samer-cyber/Robotic-Arm/docs/README.md

# Docs

| | |
|---|---|
| [calibration.md](calibration.md) | gear ratios, signs and zero, gripper, tool point: do this after flashing 1.3.0 |
| [roadmap.md](roadmap.md) | what to build next, in small steps, and which hardware upgrades are worth it |
| [gearbox.md](gearbox.md) | how the inverted cycloids work, and the J2 disc B interference |
| [wiring.md](wiring.md) | as-built pin map, power, and the schematic |
| [datasheets.md](datasheets.md) | where to get the vendor PDFs |
| [notes/direction-over-uart.md](notes/direction-over-uart.md) | firmware 1.2.0: steering the steppers over UART after the DIR pins died |
