samer-cyber/Robotic-Arm/docs/datasheets.md

# Datasheets

Vendor PDFs are not redistributed here. Keep local copies in
`hardware/datasheets/` (gitignored).

| Part | Where |
|---|---|
| TMC2209 stepper driver | [Analog Devices / Trinamic](https://www.analog.com/en/products/tmc2209.html) |
| 17HS4401S NEMA 17 stepper | the seller's sheet: 1.5 A/phase, 40 mm body, 5 mm D-shaft |
| MG996R / MG995 servos | TowerPro |
| ESP32-WROOM-32 | [Espressif](https://www.espressif.com/en/support/documents/technical-documents) |
| OAK-D SR camera | [Luxonis docs](https://docs.luxonis.com/hardware/products/OAK-D%20SR) |
| Joint-node PCB parts (ESP32-C3, MT6701, SIT65HVD230, AP63203, MP1584, USBLC6) | LCSC part pages, imported with `hardware/electronics/tools/import_lcsc.ps1` |
| CAN bus stepper reference design | "Things by Josh", the joint-node PCB's inspiration |
