samer-cyber/Robotic-Arm/hardware/calculators/Cycloidal gearbox calculator - pins.xlsx

- | CYCLOIDAL GEARBOX DESIGN - PINS VARIANT
 | ORANGE = you decide | PEACH = measure on your printer | GREY = hardware fact | LIGHT GREY = fixed constant, leave alone | BLUE = calculated | GREEN = check. Fill top to bottom, then copy the yellow block at the bottom into cycloidal_generator_pins.py.
1. YOUR MOTOR AND ITS SHAFT
T_m | Motor holding torque | 0.4 | N.m | 17HS4401S = 0.40 nameplate.
D_sh | Motor shaft diameter | 5 | mm | NEMA 17 = 5.0.
D_boss | Motor front boss diameter | 22 | mm | The raised pilot on the motor face.
L_boss | Boss length | 2 | mm | First section of the shaft, at the motor face.
L_round | Smooth round section length | 3 | mm | Between the boss and the D-cut.
L_dcut | D-cut section length | 18 | mm | The part the eccentric keys onto.
t_stand | Arm-body wall (motor to gearbox) | 3.5 | mm | The plate the motor bolts to. It EATS shaft: everything below is measured from the gearbox back face, not the motor face.
FTO | D-shaft flat-to-opposite-side | 4.5 | mm | Measured. Flat is 0.5 deep on a 5 mm shaft.
2. RATIO HELPER (optional)
T_want | Output torque you need | 7 | N.m | From the arm sizing calculator.
eta | Efficiency | 0.65 | - | Printed rollers dry 0.40-0.55 | greased 0.55-0.70 | steel dowels greased 0.70-0.85.
i_sug | -> suggested ratio |  | - | T_want / (motor x efficiency).
L_lev | MEASURED lever length | 200 | mm | Test/torque_test.py implements this.
m_scale | MEASURED scale reading at breakaway | 3565 | g | Zero the scale with the lever on it.
eta_m | -> your MEASURED efficiency |  | - | Put this back into the efficiency cell.
3. THE DECISIONS
i | Reduction ratio | 15 | - | Eccentricity is E = lambda x R / (i+1), so ratio and gearbox size TRADE OFF. Check the E verdict near the bottom before committing.
D_big | LARGE (output) bearing OUTER diameter | 52 | mm | Your size knob. R = D_big/2. A 6808 is 52.
W_big | large bearing width | 7 | mm
d_ci | CAM bearing inner diameter | 8 | mm | 608 = 8. -> eccentric journal.
d_co | cam bearing outer diameter | 22 | mm | 608 = 22. -> disc bore.
w_c | cam bearing width | 7 | mm | 608 = 7. -> disc thickness AND cavity length.
N_o | Number of output pins | 6 | - | MUST BE EVEN (4, 6 or 8).
D_o | Output PIN diameter | 4 | mm | Whatever pin you have.
5. PROFILE CLEARANCE (printer-dependent, NOT live in Fusion)
c | Profile clearance | 0.06 | mm | Shrinks the disc lobe profile for a running fit. PLA 0.05-0.08 | PETG 0.10-0.15 | ABS 0.15-0.20. Feeds every point of the spline, so changing it means re-running the script.
6. TOLERANCES - these five are LIVE Fusion parameters, all independent
t_bore | tol_disc_bore - disc centre bore | 0.1 | mm | Cam bearing OUTER race into the printed disc. Bore = d_co + this.
t_journal | tol_journal - eccentric journals | 0.1 | mm | Cam bearing INNER race onto the eccentric. Journal = d_ci - this. Separate from the bore because a thin disc shrinks onto a bearing while a shaft does not.
t_seat | tol_big_seat - big bearing seat | 0.1 | mm | Big output bearing into the stiff outer ring. Usually wants LESS than the inner fits.
t_mbore | tol_motor_bore - motor D-shaft bore | 0.05 | mm | Motor shaft into the eccentric.
t_ohole | tol_out_hole - output hole print allowance | 0.1 | mm | ON TOP of the geometric pin + 2E. Zero here guarantees binding if the printer runs undersize - that was the cause of the wobble and the Z-jumping. Set it properly: print one disc, caliper a hole, use (nominal - measured) + 0.05.
7. HOUSING AND AXIAL STACK
W | Wall thickness (outer wall + seat ring) | 3 | mm
BW | Back wall thickness | 5 | mm | THE ONE YOU TUNE. Must clear the M3 counterbore - see check 7.
cb | M3 counterbore depth | 3 | mm | 3.0 = an M3 socket cap head sits flush with the cavity floor.
BG | Back gap (cavity floor -> disc A) | 2 | mm | FIXED at 2.0. Safety gap in case a screw tip protrudes. Everything else in the axial stack is derived from this.
DG | Disc A -> disc B gap | 0.5 | mm
FG | Disc B -> output flange gap | 0.5 | mm
SP_D | Eccentric spacer diameter | 7.08 | mm
8. FIXED CONSTANTS (leave alone)
lam | Trochoid ratio lambda | 0.63 | - | Lobe depth. Band 0.40-0.80, industrial 0.50-0.75. >=1 is FATAL.
k | Roller radius / roller pitch | 0.3 | - | Coupled to lambda (k > lambda/pi).
9. CALCULATED - mechanism
R | Roller circle radius = D_big/2 |  | mm
N_r | Rollers = i + 1 |  | -
Z | Disc lobes = i |  | -
R_e | Disc bore radius = d_co/2 |  | mm
t | Disc thickness = cam width |  | mm
p | Roller pitch |  | mm
Rr_raw | Roller radius (raw) |  | mm
R_r | ROLLER RADIUS TO BUILD <- overtype |  | mm | Round to a real size ONLY if using steel dowel pins (2.5 = 5 mm dowel).
E_raw | Eccentricity (raw) |  | mm
E | ECCENTRICITY TO BUILD <- overtype |  | mm
10. CALCULATED - disc
r_max | Disc peak radius |  | mm
r_min | Disc valley radius |  | mm
OD_d | Disc outside diameter |  | mm
lobe | Lobe depth = 2E |  | mm | Your whole mesh engagement. Compare it to your print tolerance - if they are the same order of magnitude the drive will judder.
bore | DISC CENTRE HOLE to cut = d_co + tol |  | mm
11. CALCULATED - output pin holes
Dh | PIN hole to cut = pin + 2E + tol |  | mm | The +2E is geometric - without it the disc cannot orbit at all. The +tol is the print allowance on top.
L_o | Output pin circle radius |  | mm | Auto-placed halfway between bore and valley so both webs are equal and maximal.
web | Web each side (shank hole) |  | mm | The two places the disc cracks.
hgap | Gap between adjacent holes |  | mm
12. CALCULATED - housing, shaft and the derived spacer
OD_h | Housing outer diameter |  | mm
H_cav | Roller cavity length |  | mm
seat | Big-bearing SEAT bore = D_big + tol |  | mm
H_tot | Total housing height |  | mm
jnl | Journal DIA to build = d_ci - tol |  | mm
mbore | Motor D-bore = D_sh + tol |  | mm
zd0 | D-cut STARTS at z = |  | mm | z=0 is the gearbox back face. The arm-body wall eats the boss and part of the round section.
zd1 | D-cut ENDS at z = |  | mm
zA0 | Disc A bottom at z = |  | mm
zB1 | Disc B top at z = |  | mm
SP_L | SPACER LENGTH (derived) |  | mm | Sets disc A exactly BG above the cavity floor, with the spacer bottom landing on the start of the D-cut. Do not type this - it follows from the back wall.
eng | Eccentric engaged on the D-cut |  | mm | Want >= 10. This is what a thicker back wall costs you, 1:1.
bolt | Motor bolt-circle radius |  | mm | Holes at (+/-15.5, +/-15.5).
14. TORQUE
T_out | Output torque at this efficiency |  | N.m
rpm | Output speed at 240 rpm motor |  | rpm
F | Force on one loaded output pin |  | N | ~half carry load at once.
wreq | Web required for strength (PETG) |  | mm | 8 MPa allowable.
15. THE CHECKS - all must say OK
c1 | Printable gap between rollers > 1.0
c2 | Roller diameter printable >= 2.0
c3 | Web strong enough
c4 | Output holes clear each other > 2
c5 | Eccentric wall > 1.0
c6 | Output count even
c7 | M3 counterbore leaves >= 1.5 mm of back wall
c8 | Derived spacer is positive
c9 | D-cut engagement >= 10 mm
c10 | Eccentricity big enough for FDM (E >= 0.75)
16. BUILD THE OUTPUT ARM - the numbers you actually draw
 | Arm centre = motor shaft axis = big-bearing axis. Draw ONE line from that centre out to R_pin, put a hole at the end, then circular-pattern it N_o times. *** R_pin CHANGES WITH THE RATIO. *** A 15:1 arm and a 20:1 arm are 0.48 mm apart, and that mismatch alone demands about 1 mm of extra hole clearance to absorb. Re-make the arm every time you change the ratio.
R_pin | PIN CIRCLE RADIUS centre -> screw centre |  | mm | THE number. Same circle as the disc holes (OUT_PIN_R in the script) - the screws pass through both, so they must share one radius.
ang | Angle between adjacent holes |  | deg
d_arm | Hole diameter IN THE ARM | 3.95 | mm | Press fit - roughly pin diameter minus 0.05. This is NOT the disc hole: the disc hole is clearance so the pin can orbit, this one has to HOLD the pin rigid.
conc | Concentricity budget | 0.05 | mm | How far the pin circle may sit off the big-bearing axis. Any offset here shows up as ONE tight spot per input revolution and costs 2x itself in hole clearance.
# | hole coordinates (if you would rather type them than pattern) | X (mm) | Y (mm)
1 | hole 1
2 | hole 2
3 | hole 3
4 | hole 4
5 | hole 5
6 | hole 6
7 | hole 7
8 | hole 8
17. COPY INTO cycloidal_generator_pins.py
RATIO
R
PIN_R
ECC
CLEAR
CAM_ID
CAM_OD
CAM_W
BIG_OD
BIG_W
TOL_DISC_BORE
TOL_JOURNAL
TOL_BIG_SEAT
TOL_MOTOR_BORE
TOL_OUT_HOLE
OUT_PIN_D
OUT_PIN_N
OUT_PIN_R
WALL
MOTOR_SHAFT_D
MOTOR_BOSS_D
FLAT_TO_OPP
BACK_WALL
CBORE_DEPTH
BACK_GAP
DISC_GAP
FRONT_GAP
SPACER_D
MOTOR_STANDOFF
SHAFT_BOSS_L
SHAFT_ROUND_L
SHAFT_D_LEN
 | SPACER_L is NOT in this list - the script derives it, exactly like row 91 does here. Never type it.
