samer-cyber/Robotic-Arm/hardware/calculators/Cycloidal gearbox calculator - screws.xlsx

- | CYCLOIDAL GEARBOX DESIGN - SCREWS VARIANT
 | ORANGE = you decide | PEACH = measure on your printer | GREY = hardware fact | LIGHT GREY = fixed constant, leave alone | BLUE = calculated | GREEN = check. Fill top to bottom, then copy the yellow block at the bottom into cycloidal_generator_screws_hexhead.py.
1. YOUR MOTOR AND ITS SHAFT
T_m | Motor holding torque | 0.4 | N.m | 17HS4401S = 0.40 nameplate.
D_sh | Motor shaft diameter | 5 | mm | NEMA 17 = 5.0.
D_boss | Motor front boss diameter | 22 | mm | The raised pilot on the motor face.
L_boss | Boss length | 2 | mm | First section of the shaft, at the motor face.
L_round | Smooth round section length | 3 | mm | Between the boss and the D-cut.
L_dcut | D-cut section length | 18 | mm | The part the eccentric keys onto.
t_stand | Arm-body wall (motor to gearbox) | 3.5 | mm | The plate the motor bolts to. It EATS shaft: everything below is measured from the gearbox back face, not the motor face.
FTO | D-shaft flat-to-opposite-side | 4.5 | mm | Measured. Flat is 0.5 deep on a 5 mm shaft.
2. RATIO HELPER (optional)
T_want | Output torque you need | 7 | N.m | From the arm sizing calculator.
eta | Efficiency | 0.65 | - | Printed rollers dry 0.40-0.55 | greased 0.55-0.70 | steel dowels greased 0.70-0.85.
i_sug | -> suggested ratio | 27 | - | T_want / (motor x efficiency).
L_lev | MEASURED lever length | 200 | mm | Test/torque_test.py implements this.
m_scale | MEASURED scale reading at breakaway | 3565 | g | Zero the scale with the lever on it.
eta_m | -> your MEASURED efficiency | 0.6476416667 | - | Put this back into the efficiency cell.
3. THE DECISIONS
i | Reduction ratio | 20 | - | Eccentricity is E = lambda x R / (i+1), so ratio and gearbox size TRADE OFF. Check the E verdict near the bottom before committing.
D_big | LARGE (output) bearing OUTER diameter | 52 | mm | Your size knob. R = D_big/2. A 6808 is 52.
W_big | large bearing width | 7 | mm
d_ci | CAM bearing inner diameter | 8 | mm | 608 = 8. -> eccentric journal.
d_co | cam bearing outer diameter | 22 | mm | 608 = 22. -> disc bore.
w_c | cam bearing width | 7 | mm | 608 = 7. -> disc thickness AND cavity length.
N_o | Number of output screws | 6 | - | MUST BE EVEN (4, 6 or 8).
4. THE OUTPUT SCREW (measure yours with calipers)
SH_D | Screw smooth SHANK diameter | 3.9 | mm | Disc B rides on this.
HD_D | Screw HEAD diameter | 6.88 | mm | Disc A rides on this.
HD_H | Screw HEAD height | 3.84 | mm
SH_L | Screw SMOOTH length below the head | 9.5 | mm | THE number that decides whether the head-as-pin idea works cleanly. See the checks.
POCK | Head pocket depth in disc A | 4 | mm | You type this. Head is HD_H, so a touch more leaves it almost flush.
5. PROFILE CLEARANCE (printer-dependent, NOT live in Fusion)
c | Profile clearance | 0.02 | mm | Shrinks the disc lobe profile for a running fit. PLA 0.05-0.08 | PETG 0.10-0.15 | ABS 0.15-0.20. Feeds every point of the spline, so changing it means re-running the script.
6. TOLERANCES - these five are LIVE Fusion parameters, all independent
t_bore | tol_disc_bore - disc centre bore | 0.1 | mm | Cam bearing OUTER race into the printed disc. Bore = d_co + this.
t_journal | tol_journal - eccentric journals | 0.1 | mm | Cam bearing INNER race onto the eccentric. Journal = d_ci - this. Separate from the bore because a thin disc shrinks onto a bearing while a shaft does not.
t_seat | tol_big_seat - big bearing seat | 0.1 | mm | Big output bearing into the stiff outer ring. Usually wants LESS than the inner fits.
t_mbore | tol_motor_bore - motor D-shaft bore | 0.05 | mm | Motor shaft into the eccentric.
t_ohole | tol_out_hole - output hole print allowance | 0.1 | mm | ON TOP of the geometric pin + 2E. Zero here guarantees binding if the printer runs undersize - that was the cause of the wobble and the Z-jumping. Set it properly: print one disc, caliper a hole, use (nominal - measured) + 0.05.
7. HOUSING AND AXIAL STACK
W | Wall thickness (outer wall + seat ring) | 3 | mm
BW | Back wall thickness | 5 | mm | THE ONE YOU TUNE. Must clear the M3 counterbore - see check 7.
cb | M3 counterbore depth | 3 | mm | 3.0 = an M3 socket cap head sits flush with the cavity floor.
BG | Back gap (cavity floor -> disc A) | 2 | mm | FIXED at 2.0. Safety gap in case a screw tip protrudes. Everything else in the axial stack is derived from this.
DG | Disc A -> disc B gap | 0.5 | mm
FG | Disc B -> output flange gap | 0.5 | mm
SP_D | Eccentric spacer diameter | 7.08 | mm
8. FIXED CONSTANTS (leave alone)
lam | Trochoid ratio lambda | 0.63 | - | Lobe depth. Band 0.40-0.80, industrial 0.50-0.75. >=1 is FATAL.
k | Roller radius / roller pitch | 0.3 | - | Coupled to lambda (k > lambda/pi).
9. CALCULATED - mechanism
R | Roller circle radius = D_big/2 | 26 | mm
N_r | Rollers = i + 1 | 21 | -
Z | Disc lobes = i | 20 | -
R_e | Disc bore radius = d_co/2 | 11 | mm
t | Disc thickness = cam width | 7 | mm
p | Roller pitch | 7.779181809 | mm
Rr_raw | Roller radius (raw) | 2.333754543 | mm
R_r | ROLLER RADIUS TO BUILD <- overtype | 2.33 | mm | Round to a real size ONLY if using steel dowel pins (2.5 = 5 mm dowel).
E_raw | Eccentricity (raw) | 0.78 | mm
E | ECCENTRICITY TO BUILD <- overtype | 0.78 | mm
10. CALCULATED - disc
r_max | Disc peak radius | 24.43 | mm
r_min | Disc valley radius | 22.87 | mm
OD_d | Disc outside diameter | 48.86 | mm
lobe | Lobe depth = 2E | 1.56 | mm | Your whole mesh engagement. Compare it to your print tolerance - if they are the same order of magnitude the drive will judder.
bore | DISC CENTRE HOLE to cut = d_co + tol | 22.1 | mm
11. CALCULATED - output screw holes
Dh | SCREW hole to cut = shank + 2E + tol | 5.56 | mm | The +2E is geometric - without it the disc cannot orbit at all. The +tol is the print allowance on top.
Dh_h | HEAD pocket dia = head + 2E + tol | 8.54 | mm
L_o | Output screw circle radius | 16.935 | mm | Auto-placed halfway between bore and valley so both webs are equal and maximal.
web | Web each side (shank hole) | 3.155 | mm | The two places the disc cracks.
web_h | Web each side (HEAD pocket) | 1.665 | mm | The head is much fatter than the shank, so THIS is the thin one.
hgap | Gap between adjacent holes | 9.19429053 | mm
12. CALCULATED - housing, shaft and the derived spacer
OD_h | Housing outer diameter | 58 | mm
H_cav | Roller cavity length | 17 | mm
seat | Big-bearing SEAT bore = D_big + tol | 52.1 | mm
H_tot | Total housing height | 29 | mm
jnl | Journal DIA to build = d_ci - tol | 7.9 | mm
mbore | Motor D-bore = D_sh + tol | 5.05 | mm
zd0 | D-cut STARTS at z = | 1.5 | mm | z=0 is the gearbox back face. The arm-body wall eats the boss and part of the round section.
zd1 | D-cut ENDS at z = | 19.5 | mm
zA0 | Disc A bottom at z = | 7 | mm
zB1 | Disc B top at z = | 21.5 | mm
SP_L | SPACER LENGTH (derived) | 5.5 | mm | Sets disc A exactly BG above the cavity floor, with the spacer bottom landing on the start of the D-cut. Do not type this - it follows from the back wall.
eng | Eccentric engaged on the D-cut | 18 | mm | Want >= 10. This is what a thicker back wall costs you, 1:1.
bolt | Motor bolt-circle radius | 21.92031022 | mm | Holes at (+/-15.5, +/-15.5).
13. CALCULATED - does the screw actually fit?
zfl | Output flange face at z = | 22 | mm
hstop | Head top when it bottoms in the pocket | 11 | mm
sreach | Shank then reaches z = | 20.5 | mm
cgap | Gap left to the flange | 1.5 | mm | If this is > 0 the head bottoms BEFORE the thread shoulder reaches the flange, so tightening clamps the discs. Either keep the screw deliberately loose, or fix it.
bthr | Disc B riding on THREAD | 1 | mm | Thread against the hole is what makes a disc walk axially. Want 0.
pock0 | Pocket depth for ZERO clamping | 5.5 | mm
shl0 | OR: smooth shank needed for your pocket | 11 | mm
14. TORQUE
T_out | Output torque at this efficiency | 5.2 | N.m
rpm | Output speed at 240 rpm motor | 12 | rpm
F | Force on one loaded output screw | 102.3521307 | N | ~half carry load at once.
wreq | Web required for strength (PETG) | 0.9138583098 | mm | 8 MPa allowable.
15. THE CHECKS - all must say OK
c1 | Printable gap between rollers > 1.0 | OK 3.12
c2 | Roller diameter printable >= 2.0 | OK 4.66 dia
c3 | Web strong enough | OK 3.5x
c4 | Output holes clear each other > 2 | OK 9.2
c5 | Eccentric wall > 1.0 | THIN - bigger cam bearing
c6 | Output count even | OK
c7 | M3 counterbore leaves >= 1.5 mm of back wall | OK 2.0 mm left
c8 | Derived spacer is positive | OK 5.50 mm
c9 | D-cut engagement >= 10 mm | OK 18.0
c10 | Eccentricity big enough for FDM (E >= 0.75) | OK 0.78
c11 | Head pocket web >= 1.5 | OK 1.67
c12 | Screw does not clamp the discs | HEAD BOTTOMS 1.50 mm EARLY - keep it loose, or pocket 5.50 / shank 11.00
c13 | Disc B fully on smooth shank | RIDES 1.00 mm ON THREAD
16. BUILD THE OUTPUT ARM - the numbers you actually draw
 | Arm centre = motor shaft axis = big-bearing axis. Draw ONE line from that centre out to R_pin, put a hole at the end, then circular-pattern it N_o times. *** R_pin CHANGES WITH THE RATIO. *** A 15:1 arm and a 20:1 arm are 0.48 mm apart, and that mismatch alone demands about 1 mm of extra hole clearance to absorb. Re-make the arm every time you change the ratio.
R_pin | PIN CIRCLE RADIUS centre -> screw centre | 16.935 | mm | THE number. Same circle as the disc holes (OUT_SCREW_R in the script) - the screws pass through both, so they must share one radius.
ang | Angle between adjacent holes | 60 | deg
d_arm | Hole diameter IN THE ARM | 3.3 | mm | M4 coarse tap drill = 3.3. In PETG many people go 3.4-3.5 and let the screw form its own thread. This is NOT the disc hole: the disc hole is clearance so the screw can orbit, this one has to GRIP.
conc | Concentricity budget | 0.05 | mm | How far the pin circle may sit off the big-bearing axis. Any offset here shows up as ONE tight spot per input revolution and costs 2x itself in hole clearance.
# | hole coordinates (if you would rather type them than pattern) | X (mm) | Y (mm)
1 | hole 1 | 16.935 | 0.000
2 | hole 2 | 8.468 | 14.666
3 | hole 3 | -8.467 | 14.666
4 | hole 4 | -16.935 | 2.074788908e-15
5 | hole 5 | -8.468 | -14.666
6 | hole 6 | 8.468 | -14.666
7 | hole 7 | - | -
8 | hole 8 | - | -
17. COPY INTO cycloidal_generator_screws_hexhead.py
RATIO |  | 20
R |  | 26
PIN_R |  | 2.33
ECC |  | 0.78
CLEAR |  | 0.02
CAM_ID |  | 8
CAM_OD |  | 22
CAM_W |  | 7
BIG_OD |  | 52
BIG_W |  | 7
TOL_DISC_BORE |  | 0.1
TOL_JOURNAL |  | 0.04
TOL_BIG_SEAT |  | 0.09
TOL_MOTOR_BORE |  | 0.25
TOL_OUT_HOLE |  | 0.3
OUT_SCREW_N |  | 6
OUT_SCREW_R |  | 16.935
SCREW_SHANK_D |  | 3.9
SCREW_HEAD_D |  | 6.88
SCREW_HEAD_H |  | 3.84
SCREW_SHANK_L |  | 9.5
HEAD_POCKET_DEPTH |  | 4
WALL |  | 3
MOTOR_SHAFT_D |  | 5
MOTOR_BOSS_D |  | 22
FLAT_TO_OPP |  | 4.5
BACK_WALL |  | 5
CBORE_DEPTH |  | 3
BACK_GAP |  | 2
DISC_GAP |  | 0.5
FRONT_GAP |  | 0.5
SPACER_D |  | 7.08
MOTOR_STANDOFF |  | 3.5
SHAFT_BOSS_L |  | 2
SHAFT_ROUND_L |  | 3
SHAFT_D_LEN |  | 18
 | SPACER_L is NOT in this list - the script derives it, exactly like row 99 does here. Never type it.
