samer-cyber/Robotic-Arm/archive/README.md

# Archive

Kept for history. Nothing in here is current.

| | |
|---|---|
| `3dof-test-rig/` | the first bring-up firmware (ESP32-S3 + TMC2209 console, IK on the MCU). Its `docs/WIRING.md` predates the as-built pin map. Use [docs/wiring.md](../docs/wiring.md) |
| `stepper_test/` | the very first single-stepper sketch |
| `old-prints/` | superseded gearbox iterations (clearance experiments, the first classic-layout box) |
