samer-cyber/Robotic-Arm/hardware/calculators/Arm sizing calculator.xlsx

ARM SIZING -> GEAR RATIO PER JOINT
ORANGE = you decide | GREY = from your hardware | BLUE = calculated | GREEN = check. Worst case modelled: arm fully extended horizontally, payload at the tip. Fill the joint table, read the ratio column.
GLOBAL INPUTS
T_m | Motor holding torque | 0.4 | N.m | Nameplate. 17HS4401S = 0.40. Use ~0.35 if you want the honest low-speed figure.
eta | Gearbox efficiency | 0.5 | - | Printed cycloidal: 0.40-0.55 dry printed rollers, 0.55-0.70 greased, 0.70-0.85 steel dowels. Measure yours with Test/torque_test.py and put the real number here.
comp | Compensation / safety margin | 10 | % | Headroom on top of the static requirement: acceleration, stiction, and the fact that a stepper loses torque with speed. 20-30% is sensible; 0% means it can only just hold still.
m_p | Payload at the tool tip | 400 | g | Including the gripper.
alpha | Angular acceleration target | 5 | rad/s2 | Only used for ROLL joints, which carry no gravity torque. 5 rad/s2 is brisk for an arm this size.
lambda | Trochoid ratio (from the gearbox) | 0.63 | - | Same constant as the gearbox calculator. Sets eccentricity: E = lambda x R / (i+1).
E_min | Minimum acceptable eccentricity | 0.75 | mm | THE constraint that bites at high ratio. Lobe depth is 2E. At 0.75 the lobes are 1.5 mm deep, about 15x FDM tolerance - comfortable. 0.50 is marginal. Below that the mesh is tolerance noise and the drive judders.
g | Gravity | 9.81 | m/s2
THE ARM - one row per joint, proximal (base) at the top
# | joint | axis | link AFTER it (mm) | link mass (g) | actuator mass (g) | big brg OD (mm) | horizontal?
1 | base yaw | ROLL | 30 | 40 | 400 | 52 | 0
2 | shoulder pitch | PITCH | 180 | 60 | 400 | 52 | 1
3 | elbow pitch | PITCH | 150 | 50 | 400 | 52 | 1
4 | forearm roll | ROLL | 40 | 15 | 50 | 52 | 1
5 | wrist pitch | PITCH | 50 | 15 | 50 | 52 | 1
6 | tool roll | ROLL | 40 | 15 | 50 | 52 | 1
 | axis = PITCH (fights gravity) or ROLL (axis along/through the arm, gravity-neutral). horizontal? = 1 if this link adds to reach, 0 if it is the vertical base column.
CALCULATED - the ratio column is the answer
# | dist to tip (m) | link CoM (m) | distal mass (kg) | gravity torque (N.m) | inertia torque (N.m) | GOVERNING (N.m) | ratio needed | BUILD RATIO | E at this ratio (mm) | E check / min big-brg OD
1 | 0.460 | 0.460 | 1.545 | 3.41 | 1.63 | 1.63 | 9.0 | 9 | 1.638 | OK
2 | 0.460 | 0.370 | 1.105 | 3.41 | 1.17 | 3.41 | 18.8 | 19 | 0.819 | OK
3 | 0.280 | 0.205 | 0.645 | 1.51 | 0.25 | 1.51 | 8.3 | 9 | 1.638 | OK
4 | 0.130 | 0.110 | 0.545 | 0.60 | 0.05 | 0.05 | 0.3 | 5 | 2.730 | OK
5 | 0.090 | 0.065 | 0.480 | 0.39 | 0.02 | 0.39 | 2.2 | 5 | 2.730 | OK
6 | 0.040 | 0.020 | 0.415 | 0.16 | 0.00332 | 0.00332 | 0.01826 | 5 | 2.730 | OK
TOTALS
reach | Horizontal reach (J2 to tool tip) | 46.00 | cm | Sum of every link flagged horizontal. The vertical base column is excluded.
height | Base column height | 3.00 | cm
m_arm | Total moving mass (no payload) | 1.15 | kg | Excludes the base actuator, which the arm does not carry.
m_all | Total incl. payload | 1.54 | kg
T_max | Worst joint torque | 3.41 | N.m
i_max | Highest ratio needed | 19.00 | -
RECOMMENDED LENGTHS AND SANITY NOTES
Reach target | 40-50 cm horizontal is the realistic band for a 500 g payload on NEMA 17s. Every extra cm of forearm multiplies the shoulder torque by the whole distal mass.
Base column | 100-150 mm. Vertical, so it costs you nothing in torque - it only sets working height.
Upper arm (J2-J3) | 180-220 mm.
Forearm (J3-J5) | 160-200 mm. Keep it at or below the upper arm; mass out here is the single most expensive thing on the arm.
Wrist to tool tip | 60-100 mm. Shorter is strictly better - it multiplies against everything.
Proportions | Upper arm : forearm around 1 : 0.85-1.0 is the usual, roughly human. A spherical wrist (last 3 axes intersecting) gives closed-form IK - design for one.
Actuator mass | NEMA 17 (17HS4401S) is ~280 g, printed cycloidal ~120-150 g, so ~400-430 g per joint. Six of those is ~2.5 kg - FIVE TIMES the payload. The arm is mostly carrying itself, which is why the wrist actuators dominate the shoulder number.
Biggest lever | Putting SMALLER motors (NEMA 14/11) on J4-J6 cuts the shoulder requirement more than any other change. Try it in the table: drop the last three to 150 g and watch the shoulder ratio fall.
Second lever | Efficiency. Going 0.50 -> 0.75 (steel dowel rollers, greased) cuts every ratio by a third for free.
Third lever | A counterbalance spring or gas strut at the shoulder removes the static gravity term almost entirely. Common on hobby arms and very effective.
If E says LOW | Either use a bigger big-bearing at that joint (the column tells you the minimum OD), or split into two stages - e.g. a 3:1 belt pre-stage plus a 15:1 cycloidal gives 45:1 with E = 1.02 mm instead of 0.36 mm.
