samer-cyber/Robotic-Arm/description/meshes/wrist_pitch.stl

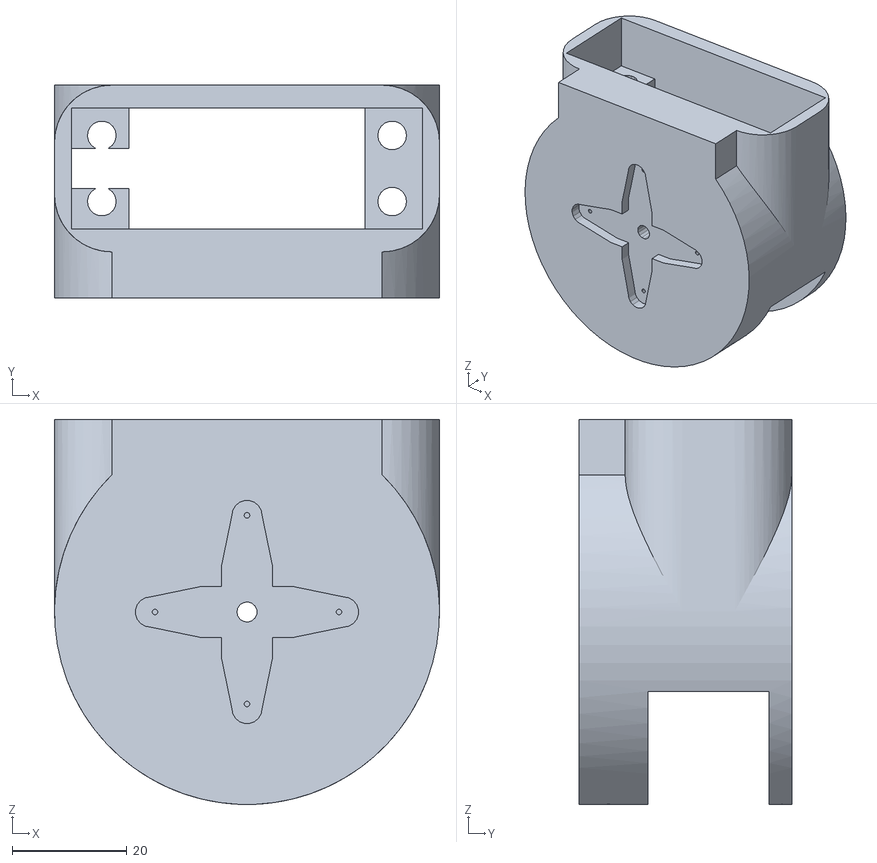
[picture p5: CAD file, 2026-11-07]
description/meshes/wrist_pitch.stl
67.0 x 37.0 x 67.0
