samer-cyber/Robotic-Arm/hardware/stl/arm/Body 4.stl

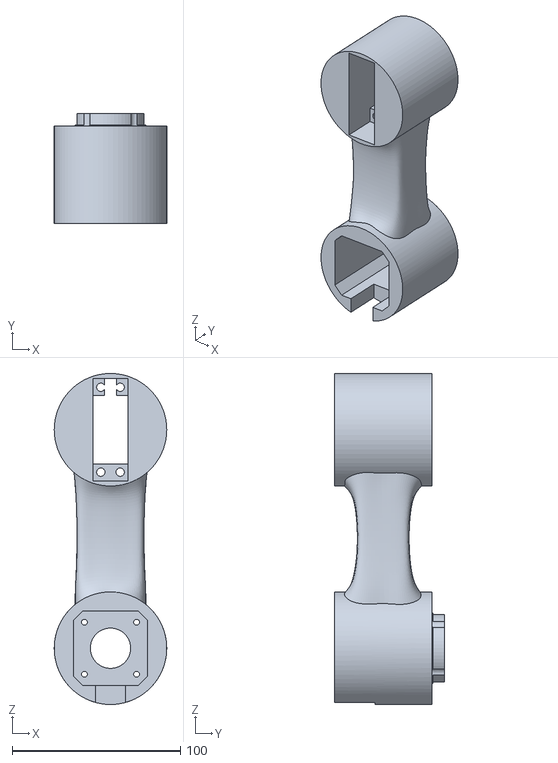
[picture p6: CAD file, 2026-11-07]
hardware/stl/arm/Body 4.stl
67.0 x 65.5 x 196.9
