samer-cyber/Robotic-Arm/hardware/stl/gearbox-15/Cycloidal disc B.stl

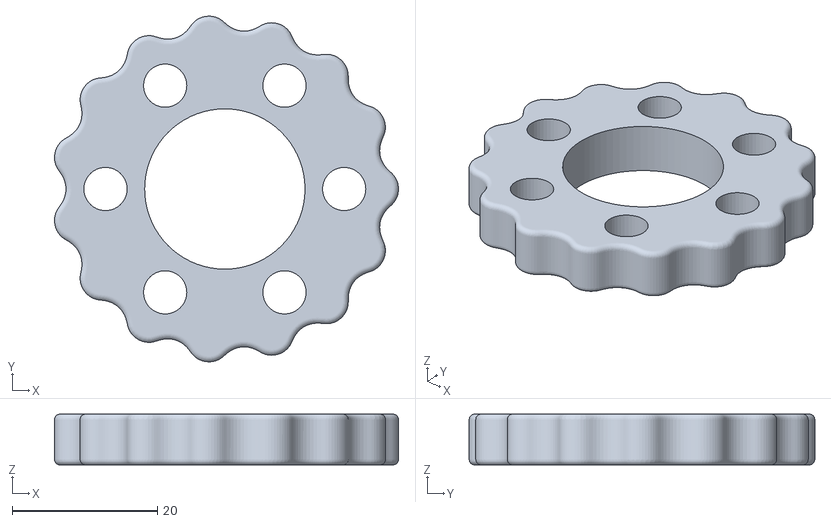
[picture p7: CAD file, 2026-11-07]
hardware/stl/gearbox-15/Cycloidal disc B.stl
47.4 x 47.6 x 7.00
