samer-cyber/Robotic-Arm/hardware/stl/gearbox-20/Cycloidal disc A.stl

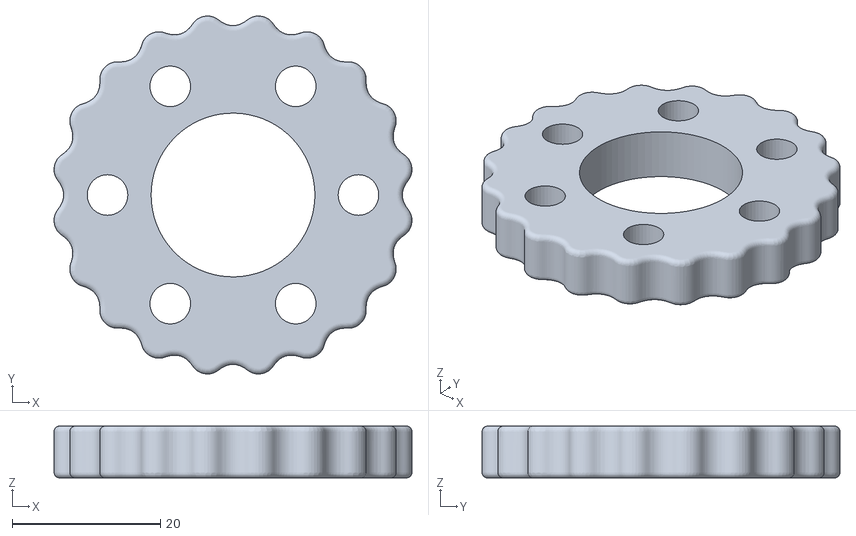
[picture p8: CAD file, 2026-11-07]
hardware/stl/gearbox-20/Cycloidal disc A.stl
48.3 x 48.3 x 7.00
