samer-cyber/Robotic-Arm/hardware/stl/test-prints/inverted-gearbox-test/Body 2.stl

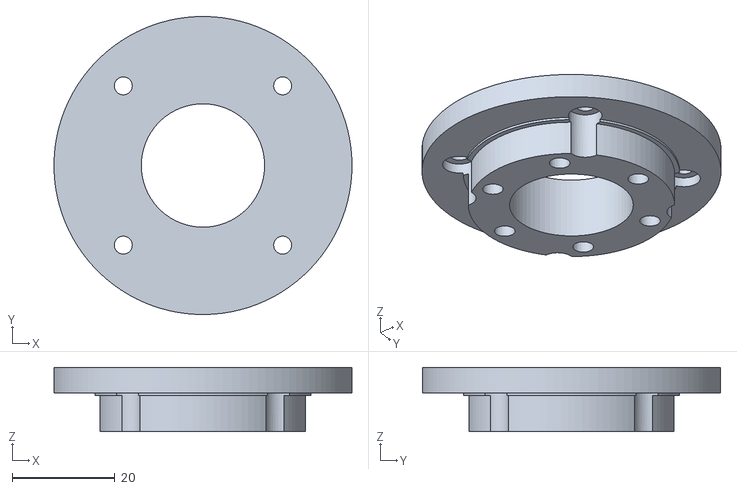
[picture p9: CAD file, 2026-11-07]
hardware/stl/test-prints/inverted-gearbox-test/Body 2.stl
58.0 x 58.0 x 12.5
