samer-cyber/Robotic-Arm/description/meshes/forearm.stl

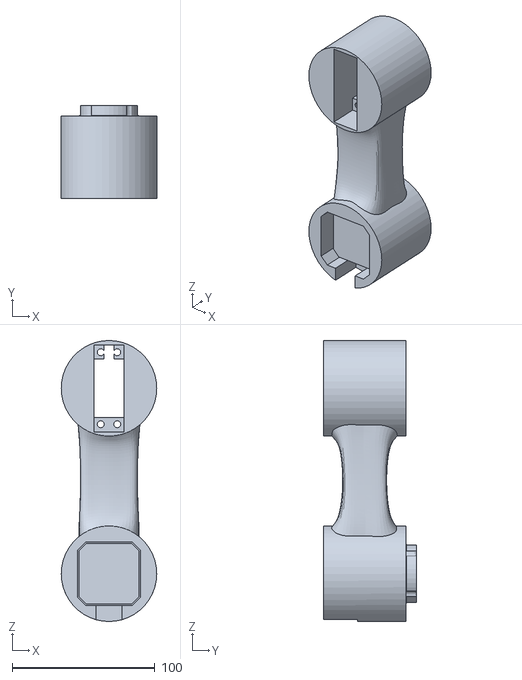
[picture p10: CAD file, 2026-11-07]
description/meshes/forearm.stl
67.0 x 65.5 x 197.0
