samer-cyber/Robotic-Arm/hardware/stl/arm/Body 7.stl

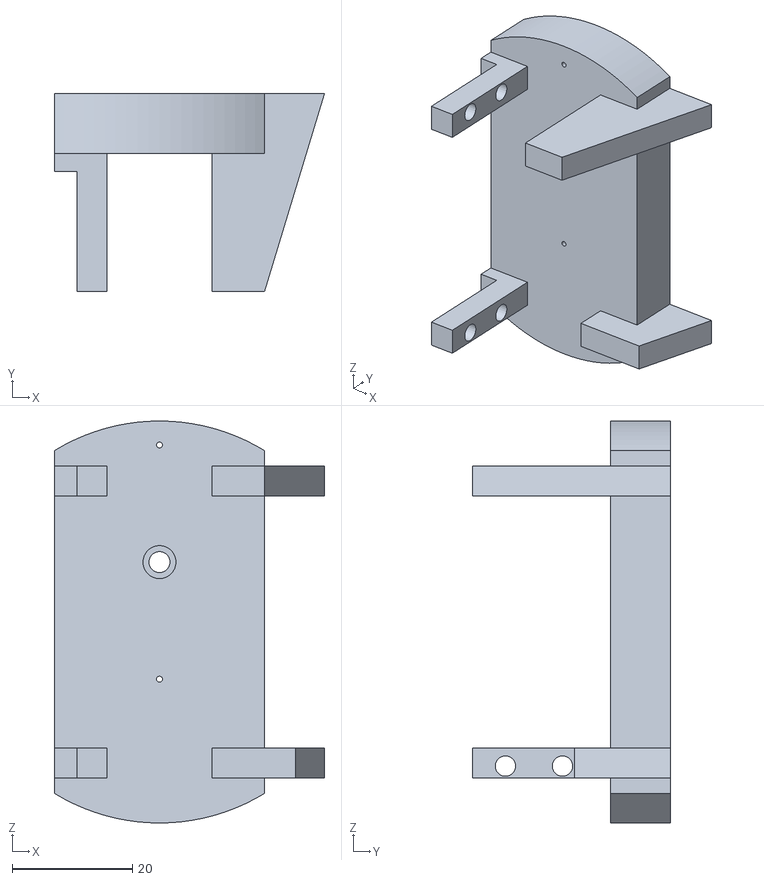
[picture p11: CAD file, 2026-11-07]
hardware/stl/arm/Body 7.stl
45.0 x 33.0 x 67.0
