samer-cyber/Robotic-Arm/hardware/stl/gearbox-15/Cycloidal disc A (1 bearing).stl

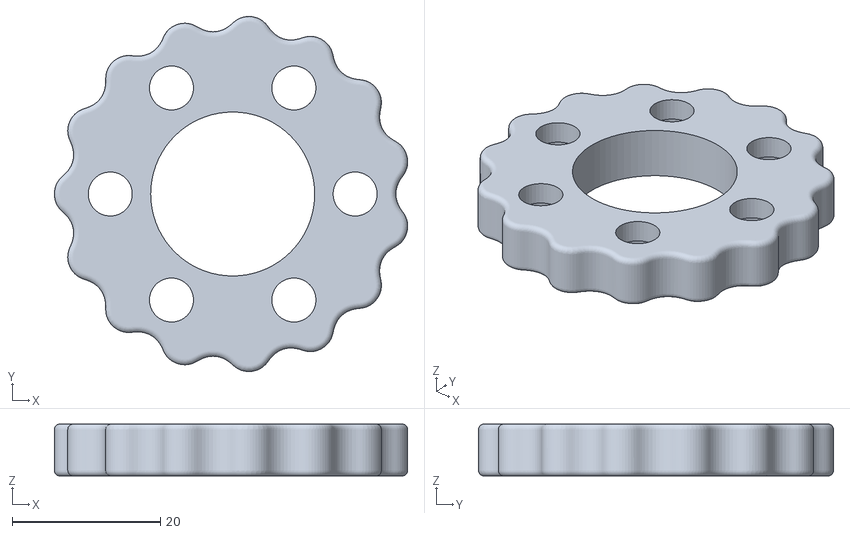
[picture p12: CAD file, 2026-11-07]
hardware/stl/gearbox-15/Cycloidal disc A (1 bearing).stl
47.6 x 47.8 x 7.00
