samer-cyber/Robotic-Arm/hardware/stl/gearbox-20/Eccentric shaft.stl

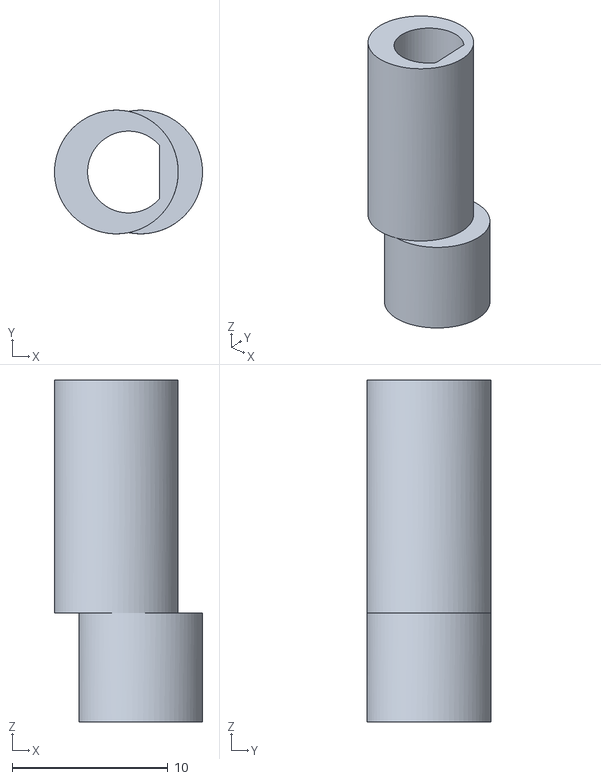
[picture p13: CAD file, 2026-11-07]
hardware/stl/gearbox-20/Eccentric shaft.stl
9.50 x 7.94 x 22.0
