samer-cyber/Robotic-Arm/hardware/stl/test-prints/inverted-gearbox-test/Body 1.stl

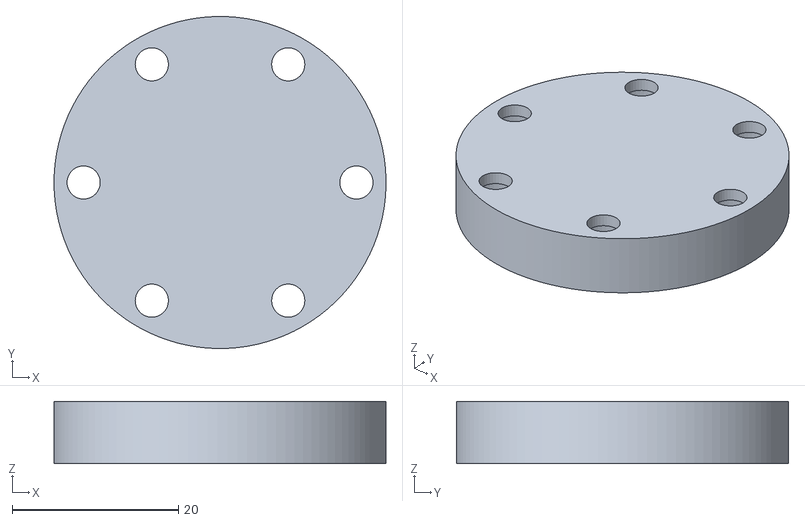
[picture p14: CAD file, 2026-11-07]
hardware/stl/test-prints/inverted-gearbox-test/Body 1.stl
40.0 x 40.0 x 7.50
