samer-cyber/Robotic-Arm/description/meshes/base_link.stl

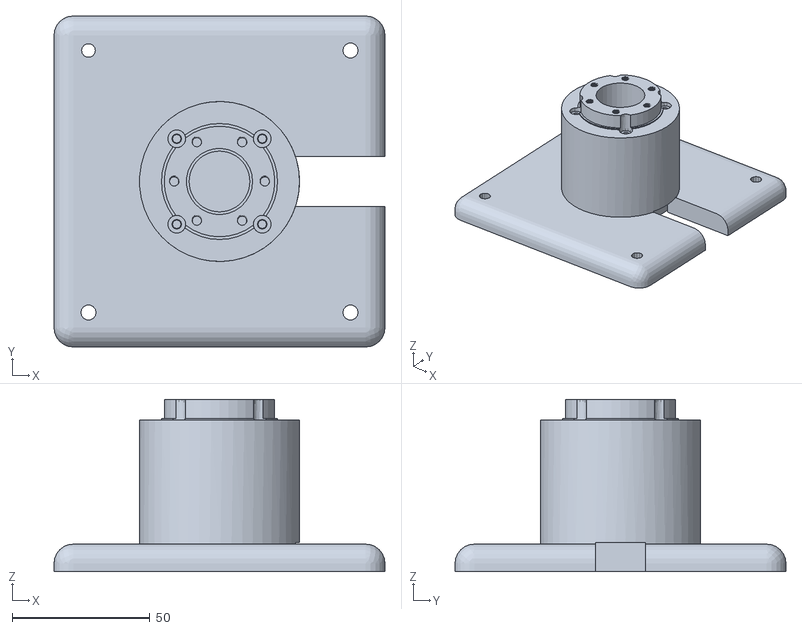
[picture p15: CAD file, 2026-11-07]
description/meshes/base_link.stl
120.0 x 120.0 x 62.5
