samer-cyber/Robotic-Arm/hardware/stl/arm/Body 1.stl

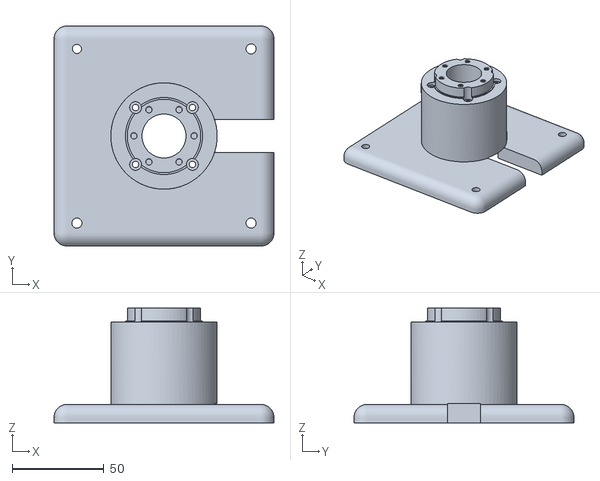
[picture p16: CAD file, 2026-11-07]
hardware/stl/arm/Body 1.stl
120.0 x 120.0 x 62.5
