samer-cyber/Robotic-Arm/hardware/stl/gearbox-20/Housing 2.stl

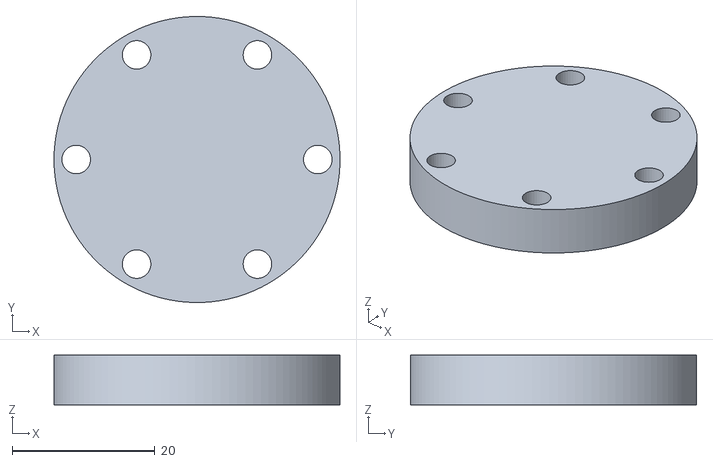
[picture p17: CAD file, 2026-11-07]
hardware/stl/gearbox-20/Housing 2.stl
40.1 x 40.1 x 7.00
