samer-cyber/Robotic-Arm/hardware/stl/test-prints/inverted-gearbox-test/Arm.stl

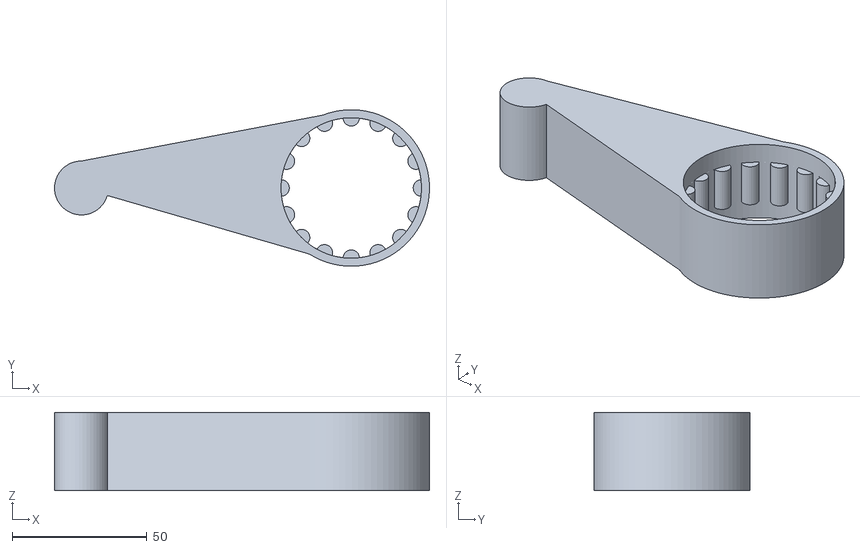
[picture p18: CAD file, 2026-11-07]
hardware/stl/test-prints/inverted-gearbox-test/Arm.stl
139.0 x 58.0 x 29.0
