samer-cyber/Robotic-Arm/description/meshes/turret.stl

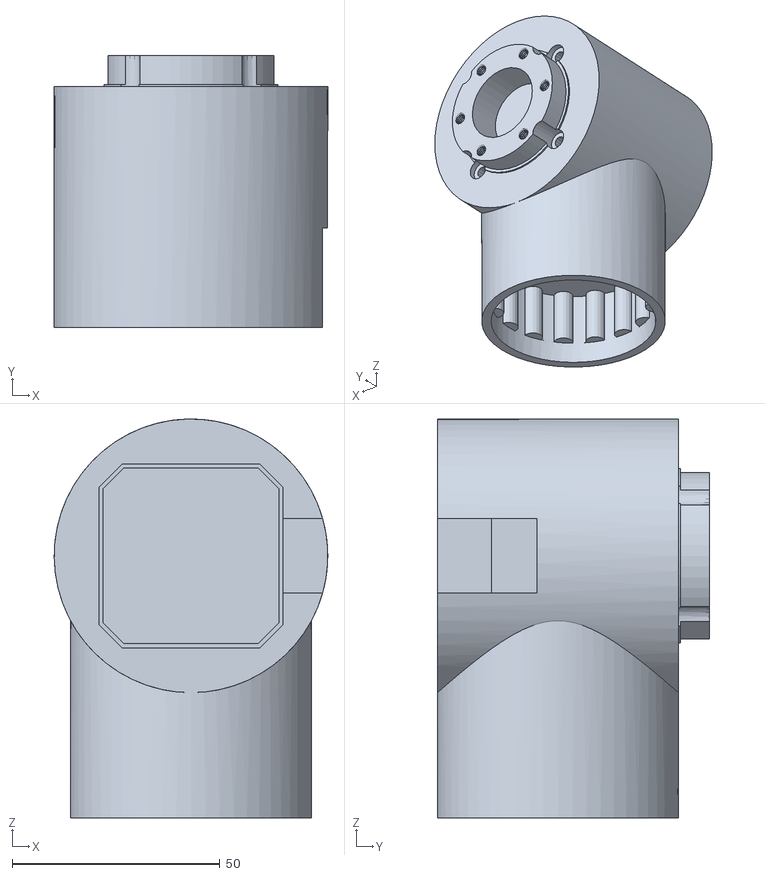
[picture p19: CAD file, 2026-11-07]
description/meshes/turret.stl
65.9 x 65.5 x 96.1
