samer-cyber/Robotic-Arm/hardware/stl/arm/Body 3.stl

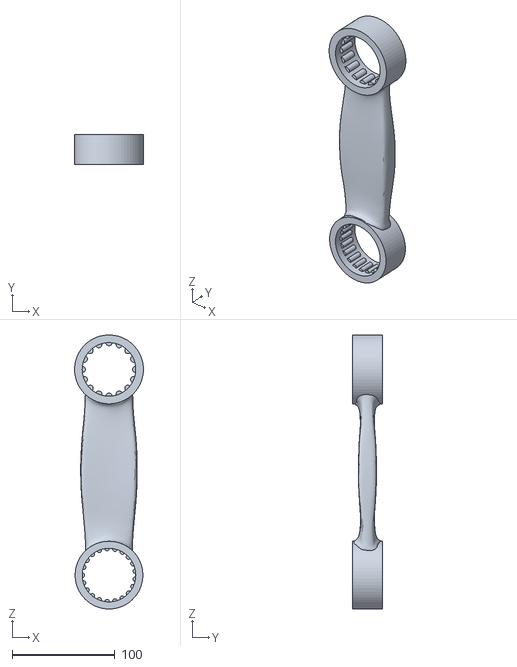
[picture p20: CAD file, 2026-11-07]
hardware/stl/arm/Body 3.stl
67.0 x 29.0 x 266.4
