samer-cyber/Robotic-Arm/hardware/stl/arm/Body 6.stl

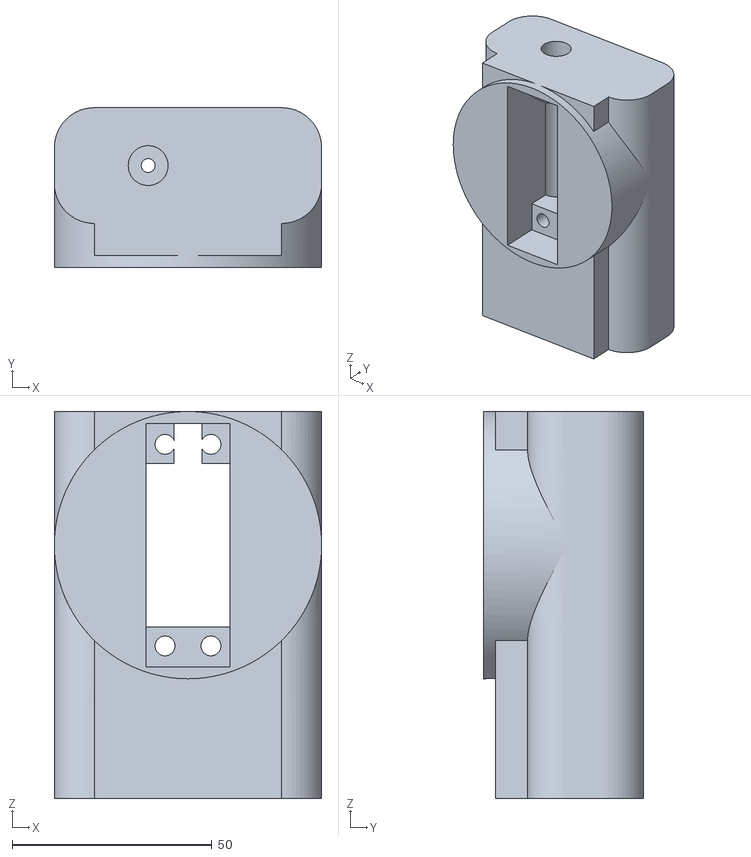
[picture p21: CAD file, 2026-11-07]
hardware/stl/arm/Body 6.stl
67.0 x 40.0 x 97.0
