samer-cyber/Robotic-Arm/hardware/stl/gearbox-15/Eccentric shaft (1 bearing).stl

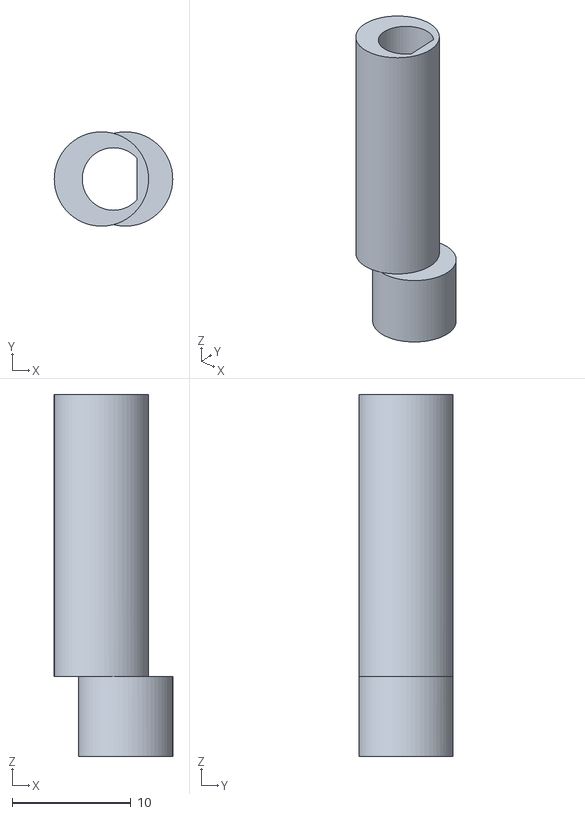
[picture p22: CAD file, 2026-11-07]
hardware/stl/gearbox-15/Eccentric shaft (1 bearing).stl
9.99 x 7.94 x 30.5
