samer-cyber/Robotic-Arm/hardware/stl/gearbox-20/Housing.stl

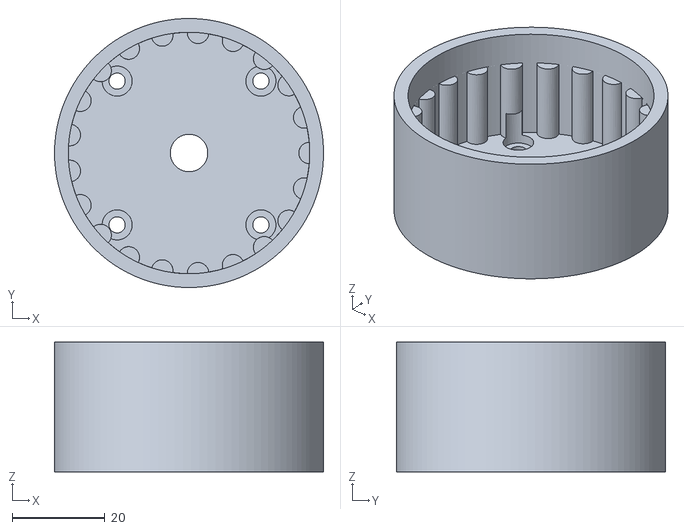
[picture p23: CAD file, 2026-11-07]
hardware/stl/gearbox-20/Housing.stl
58.0 x 58.0 x 28.0
