samer-cyber/Robotic-Arm/description/meshes/upper_arm.stl

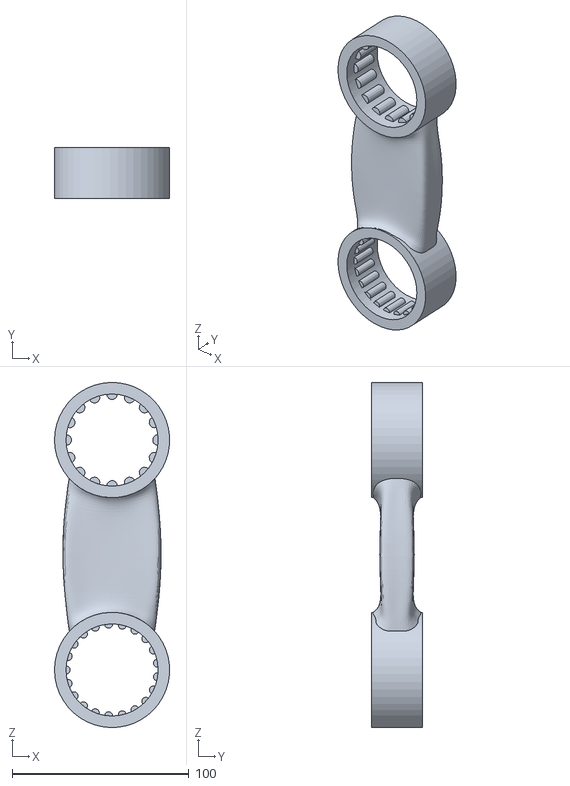
[picture p24: CAD file, 2026-11-07]
description/meshes/upper_arm.stl
65.0 x 29.0 x 195.1
