samer-cyber/Robotic-Arm/hardware/stl/arm/Body 2.stl

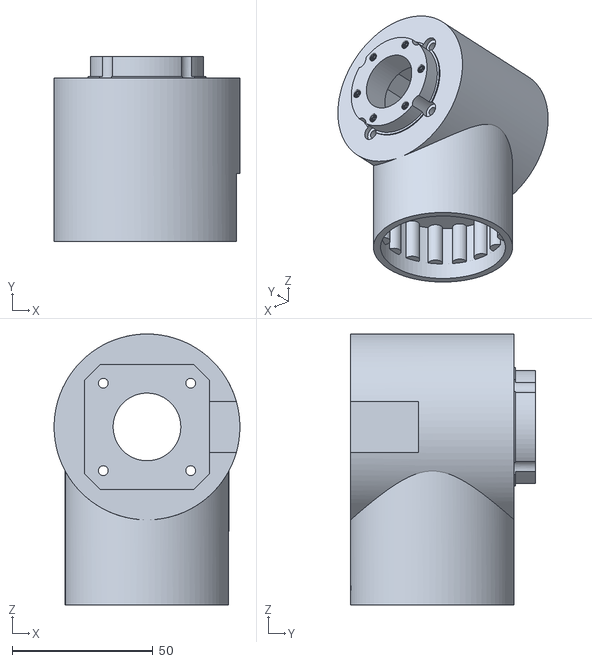
[picture p25: CAD file, 2026-11-07]
hardware/stl/arm/Body 2.stl
65.9 x 65.5 x 96.1
