samer-cyber/Robotic-Arm/hardware/stl/gearbox-15/Eccentric shaft (2 bearings).stl

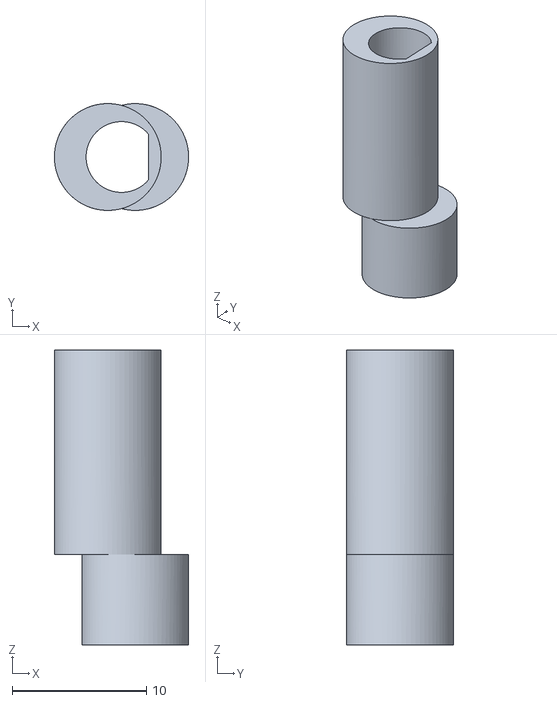
[picture p26: CAD file, 2026-11-07]
hardware/stl/gearbox-15/Eccentric shaft (2 bearings).stl
9.99 x 7.95 x 22.0
