samer-cyber/Robotic-Arm/(list of files, cad)

Other CAD files:
hardware/stl/gearbox-15/Cycloidal disc A (2 bearings).stl
hardware/stl/gearbox-15/Housing (2 bearing).stl
hardware/stl/gearbox-20/Cycloidal disc B.stl
description/meshes/tool_mount.stl
description/meshes/wrist_roll.stl
hardware/stl/arm/Body 5.stl
archive/old-prints/first-gearbox/Cycloidal disc A.stl
archive/old-prints/first-gearbox/Cycloidal disc B.stl
archive/old-prints/first-gearbox/Housing.stl
archive/old-prints/first-gearbox/Output.stl
archive/old-prints/first-gearbox/Test Body.stl
archive/old-prints/gearbox-15/Cycloidal disc A (0.15 clr).stl
archive/old-prints/gearbox-15/Cycloidal disc A (weird).stl
archive/old-prints/gearbox-15/Cycloidal disc A.stl
archive/old-prints/gearbox-15/Cycloidal disc B (0.15 clr).stl
archive/old-prints/gearbox-15/Cycloidal disc B.stl
archive/old-prints/gearbox-15/Eccentric shaft (0.15 clr).stl
archive/old-prints/gearbox-15/Eccentric shaft.stl
archive/old-prints/gearbox-15/Housing.stl
archive/old-prints/gearbox-15/test output.stl
