samer-cyber/Robotic-Arm/description/robotic_arm.urdf

<?xml version="1.0"?>
<!-- generated by description/tools/build_description.py from arm.json - do not edit -->
<robot name="robotic_arm">
  <material name="printed"><color rgba="0.12 0.12 0.13 1"/></material>
  <link name="base_link">
    <inertial><origin xyz="-0.00112487 7.86279e-06 0.0179175" rpy="0 0 0"/><mass value="0.9000"/>
      <inertia ixx="9.364e-04" ixy="3.280e-07" ixz="-1.325e-05" iyy="8.923e-04" iyz="9.116e-08" izz="1.308e-03"/></inertial>
    <visual><geometry><mesh filename="meshes/base_link.stl" scale="0.001 0.001 0.001"/></geometry><material name="printed"/></visual>
    <collision><geometry><mesh filename="meshes/base_link.stl" scale="0.001 0.001 0.001"/></geometry></collision>
  </link>
  <link name="turret">
    <inertial><origin xyz="-0.000588497 0.0035119 0.0480425" rpy="0 0 0"/><mass value="0.5500"/>
      <inertia ixx="4.194e-04" ixy="-6.654e-06" ixz="2.624e-06" iyy="4.351e-04" iyz="-1.566e-05" izz="2.937e-04"/></inertial>
    <visual><geometry><mesh filename="meshes/turret.stl" scale="0.001 0.001 0.001"/></geometry><material name="printed"/></visual>
    <collision><geometry><mesh filename="meshes/turret.stl" scale="0.001 0.001 0.001"/></geometry></collision>
  </link>
  <link name="upper_arm">
    <inertial><origin xyz="-4.55631e-05 0.0439999 0.0654363" rpy="0 0 0"/><mass value="0.2000"/>
      <inertia ixx="5.315e-04" ixy="1.693e-10" ixz="-7.282e-08" iyy="5.896e-04" iyz="-5.582e-10" izz="7.739e-05"/></inertial>
    <visual><geometry><mesh filename="meshes/upper_arm.stl" scale="0.001 0.001 0.001"/></geometry><material name="printed"/></visual>
    <collision><geometry><mesh filename="meshes/upper_arm.stl" scale="0.001 0.001 0.001"/></geometry></collision>
  </link>
  <link name="forearm">
    <inertial><origin xyz="3.90796e-08 0.00196513 0.0595676" rpy="0 0 0"/><mass value="0.4500"/>
      <inertia ixx="1.671e-03" ixy="2.470e-10" ixz="6.138e-10" iyy="1.703e-03" iyz="4.822e-05" izz="2.361e-04"/></inertial>
    <visual><geometry><mesh filename="meshes/forearm.stl" scale="0.001 0.001 0.001"/></geometry><material name="printed"/></visual>
    <collision><geometry><mesh filename="meshes/forearm.stl" scale="0.001 0.001 0.001"/></geometry></collision>
  </link>
  <link name="wrist_pitch">
    <inertial><origin xyz="0.000587852 0.0470405 0.00308541" rpy="0 0 0"/><mass value="0.1000"/>
      <inertia ixx="4.499e-05" ixy="-4.385e-07" ixz="-3.466e-07" iyy="6.746e-05" iyz="-1.371e-06" izz="5.399e-05"/></inertial>
    <visual><geometry><mesh filename="meshes/wrist_pitch.stl" scale="0.001 0.001 0.001"/></geometry><material name="printed"/></visual>
    <collision><geometry><mesh filename="meshes/wrist_pitch.stl" scale="0.001 0.001 0.001"/></geometry></collision>
  </link>
  <link name="wrist_roll">
    <inertial><origin xyz="0.0103544 -0.00418236 0.0478018" rpy="0 0 0"/><mass value="0.1000"/>
      <inertia ixx="9.197e-05" ixy="-1.483e-07" ixz="2.239e-07" iyy="1.209e-04" iyz="1.620e-06" izz="5.238e-05"/></inertial>
    <visual><geometry><mesh filename="meshes/wrist_roll.stl" scale="0.001 0.001 0.001"/></geometry><material name="printed"/></visual>
    <collision><geometry><mesh filename="meshes/wrist_roll.stl" scale="0.001 0.001 0.001"/></geometry></collision>
  </link>
  <link name="tool_mount">
    <inertial><origin xyz="0.00138481 -0.0353588 -0.0097078" rpy="0 0 0"/><mass value="0.1500"/>
      <inertia ixx="6.206e-05" ixy="6.944e-07" ixz="-1.931e-06" iyy="7.622e-05" iyz="2.766e-06" izz="2.419e-05"/></inertial>
    <visual><geometry><mesh filename="meshes/tool_mount.stl" scale="0.001 0.001 0.001"/></geometry><material name="printed"/></visual>
    <collision><geometry><mesh filename="meshes/tool_mount.stl" scale="0.001 0.001 0.001"/></geometry></collision>
  </link>
  <joint name="J1" type="revolute">
    <parent link="base_link"/><child link="turret"/>
    <origin xyz="0 0 0.0625" rpy="0 0 0"/><axis xyz="0 0 1"/>
    <limit lower="-3.1416" upper="3.1416" effort="8.0" velocity="1.0"/>
  </joint>
  <joint name="J2" type="revolute">
    <parent link="turret"/><child link="upper_arm"/>
    <origin xyz="0 0 0.05615" rpy="0 0 0"/><axis xyz="0 1 0"/>
    <limit lower="-2.0944" upper="2.0944" effort="8.0" velocity="1.0"/>
  </joint>
  <joint name="J3" type="revolute">
    <parent link="upper_arm"/><child link="forearm"/>
    <origin xyz="0 0 0.13" rpy="0 0 0"/><axis xyz="0 1 0"/>
    <limit lower="-2.0944" upper="2.0944" effort="8.0" velocity="1.0"/>
  </joint>
  <joint name="J4" type="revolute">
    <parent link="forearm"/><child link="wrist_pitch"/>
    <origin xyz="0 0 0.13" rpy="0 0 0"/><axis xyz="0 1 0"/>
    <limit lower="-2.0944" upper="2.0944" effort="1.2" velocity="1.0"/>
  </joint>
  <joint name="J5" type="revolute">
    <parent link="wrist_pitch"/><child link="wrist_roll"/>
    <origin xyz="-0.01 0.0545 0.03495" rpy="0 0 0"/><axis xyz="0 0 1"/>
    <limit lower="-2.0944" upper="2.0944" effort="1.2" velocity="1.0"/>
  </joint>
  <joint name="J6" type="revolute">
    <parent link="wrist_roll"/><child link="tool_mount"/>
    <origin xyz="0.01 0 0.07505" rpy="0 0 0"/><axis xyz="0 1 0"/>
    <limit lower="-2.0944" upper="2.0944" effort="1.2" velocity="1.0"/>
  </joint>
  <link name="tcp"/>
  <joint name="tcp_fixed" type="fixed">
    <parent link="tool_mount"/><child link="tcp"/>
    <origin xyz="0.005 -0.045 0.11135" rpy="0 0 0"/>
  </joint>
</robot>
