samer-cyber/Robotic-Arm/hardware/electronics/wiring/arm-wiring.pdf

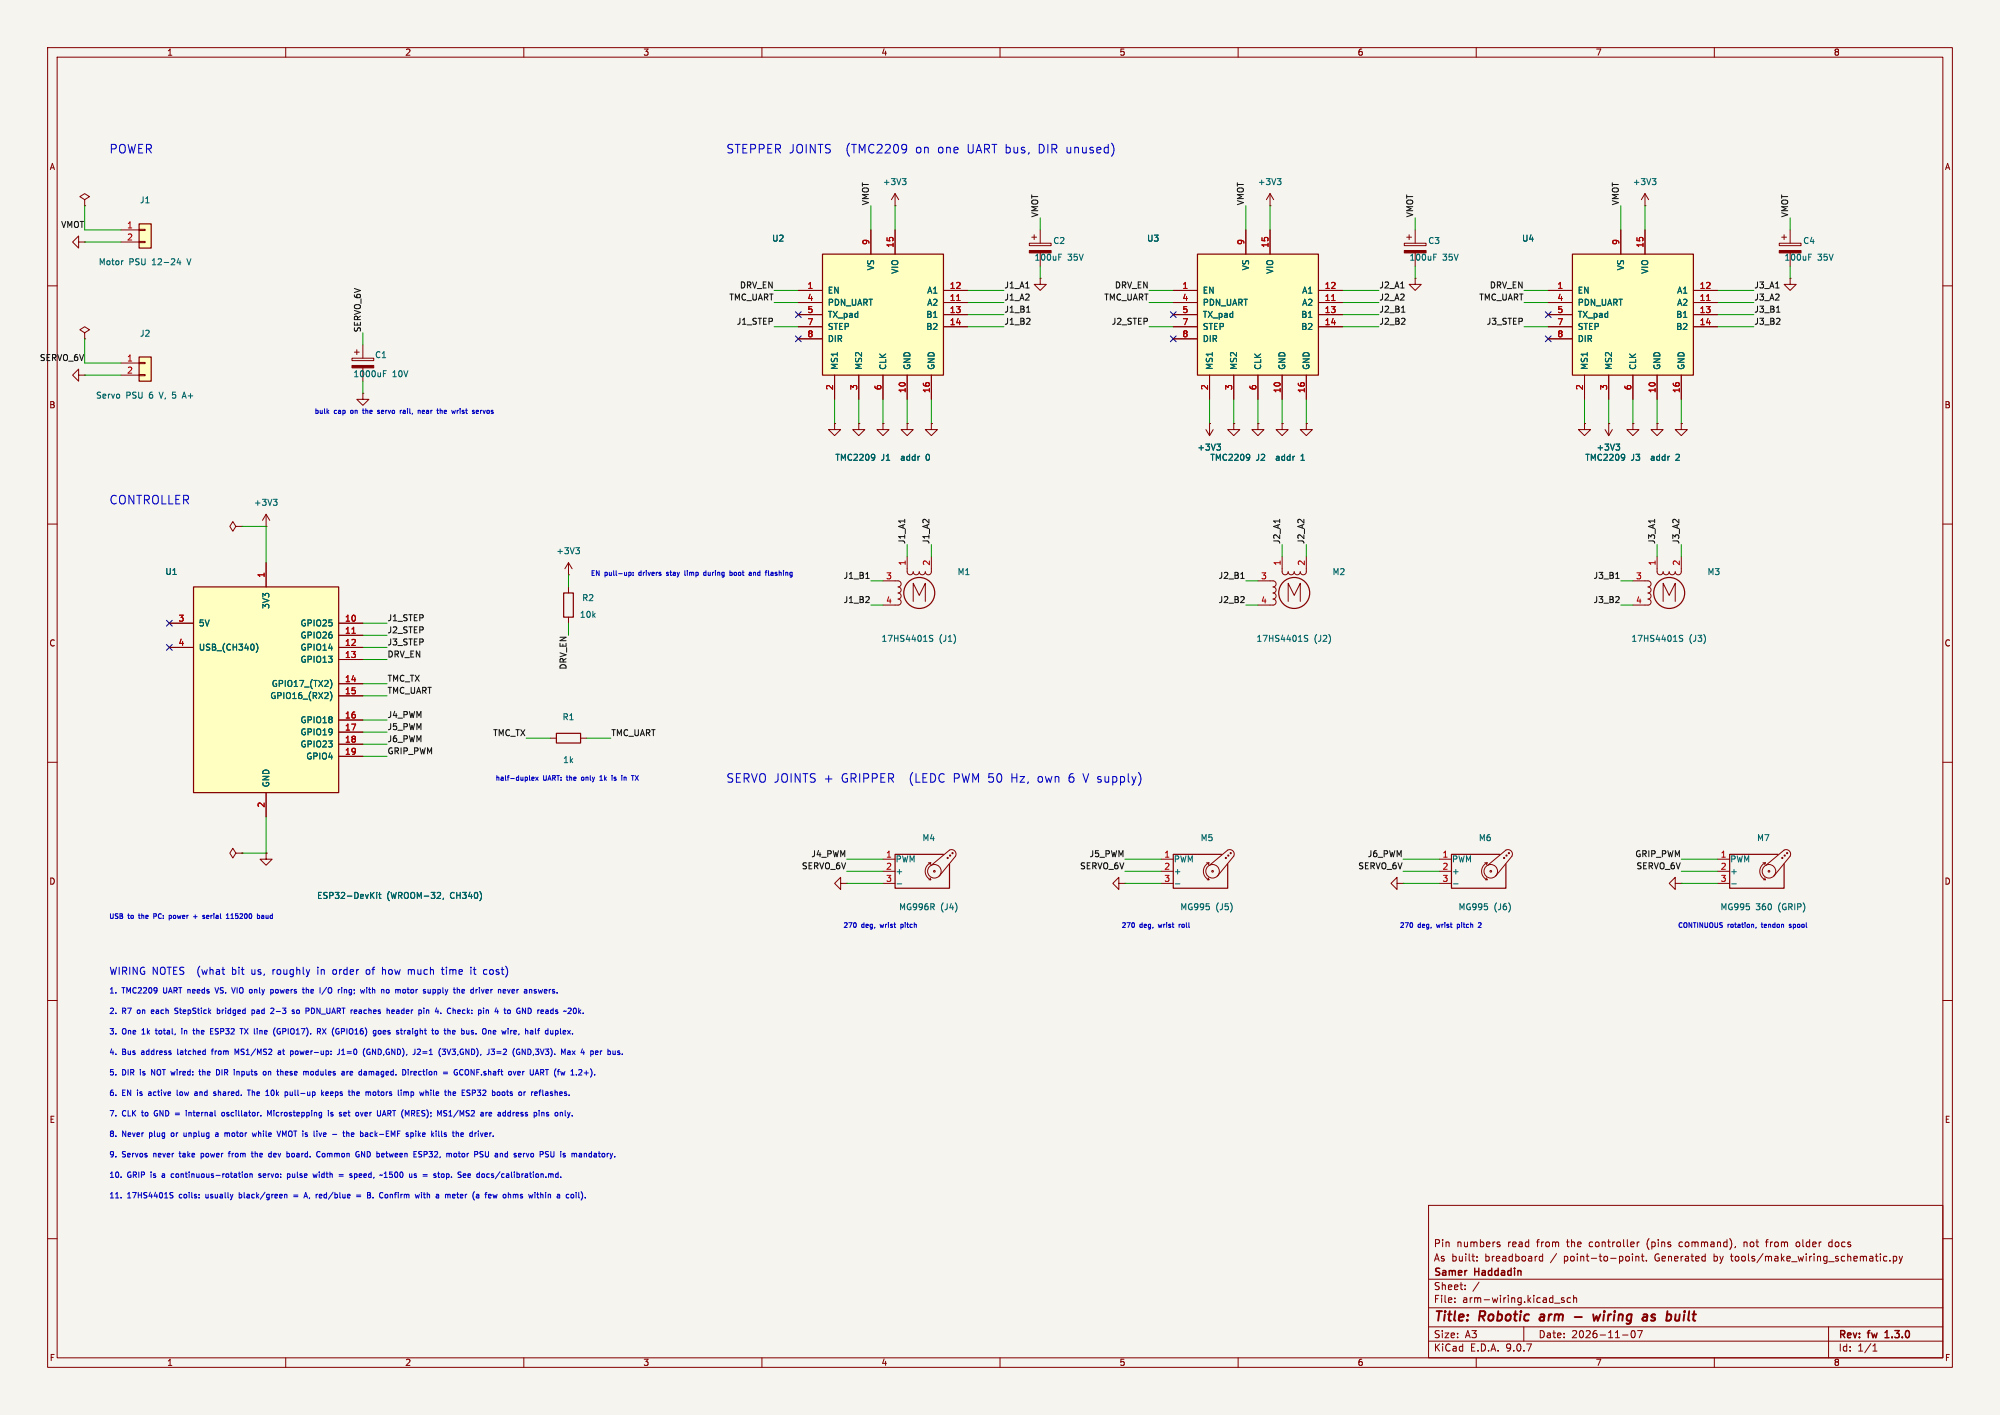
[picture p28: page 1]

STEPPER JOINTS (TMC2209 on one UART bus, DIR unused)

6 VIO 15 GND 10 GND 16 A1 12 A2 11 B1 13 B2 14 U2 TMC2209 J1 addr 0 +3V3

6 VIO 15 GND 10 GND 16 A1 12 A2 11 B1 13 B2 14 U3 TMC2209 J2 addr 1 +3V3 +3V3

6 VIO 15 GND 10 GND 16 A1 12 A2 11 B1 13 B2 14 U3 TMC2209 J2 addr 1 EN 1 PDN_UART 4 TX_pad 5 STEP 7 DIR 8 MS1

6 VIO 15 GND 10 GND 16 A1 12 A2 11 B1 13 B2 14 +3V3 U4 TMC2209 J3 addr 2 EN 1 PDN_UART 4 TX_pad 5 STEP 7 DIR 8 MS1
