samer-cyber/Robotic-Arm/hardware/electronics/can-stepper-node/Robotic Arm.kicad_pcb

## KiCad design hardware/electronics/can-stepper-node/Robotic Arm.kicad_pcb (2026-11-07)

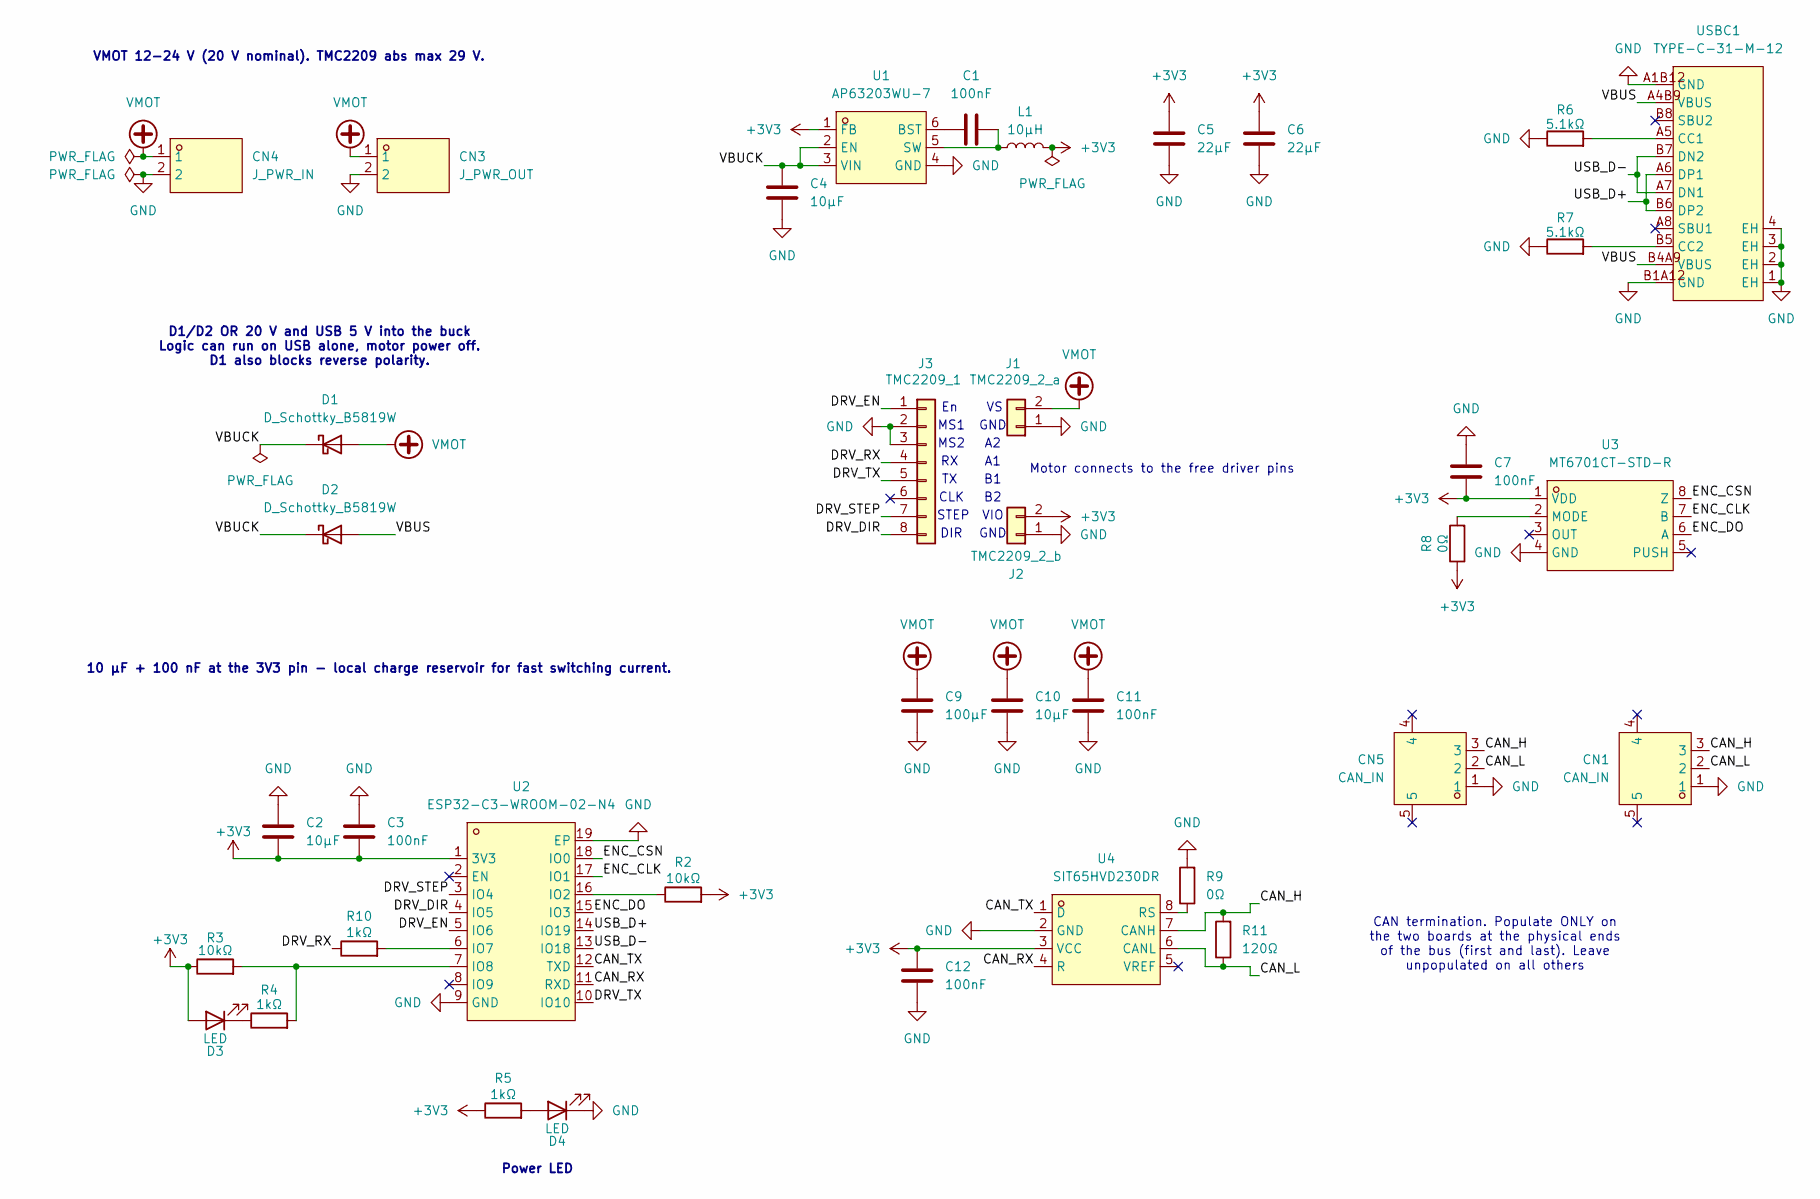
[picture p29: schematic Robotic Arm.kicad_sch, 6-DOF CANbus Stepper Node]

Parts:
C1, C3, C7, C11, C12: 100nF; C_0603_1608Metric
C2, C4, C10: 10µF; C_1206_3216Metric
C5, C6: 22µF; C_0805_2012Metric
C9: 100µF; CP_Radial_D8.0mm_P3.50mm
CN1, CN5: CAN_IN; CONN-SMD_SM03B-SRSS-TB-LF-SN-P; MPN SM03B-SRSS-TB(LF)(SN); LCSC Part C160403
CN3: J_PWR_OUT; CONN-TH_S2P-VH-LF-SN; MPN S2P-VH(LF)(SN); LCSC Part C160355
CN4: J_PWR_IN; CONN-TH_S2P-VH-LF-SN; MPN S2P-VH(LF)(SN); LCSC Part C160355
D1, D2: D_Schottky_B5819W; D_SOD-123
D3, D4: LED; LED_0603_1608Metric
J1: TMC2209_2_a; PinSocket_1x02_P2.54mm_Vertical
J2: TMC2209_2_b; PinSocket_1x02_P2.54mm_Vertical
J3: TMC2209_1; PinSocket_1x08_P2.54mm_Vertical
L1: 10µH; L_Changjiang_FNR4020S
R2, R3: 10kΩ; R_0603_1608Metric
R4, R5, R10: 1kΩ; R_0603_1608Metric
R6, R7: 5.1kΩ; R_0603_1608Metric
R8, R9: 0Ω; R_0603_1608Metric
R11: 120Ω; R_0603_1608Metric
U1: AP63203WU-7; TSOT-26_L2.9-W1.6-P0.95-LS2.8-BL; MPN AP63203WU-7; LCSC Part C780769
U2: ESP32-C3-WROOM-02-N4; BULETM-SMD_ESPRESSIF_ESP32-C3-WROOM-02-N4-4MB; MPN ESP32-C3-WROOM-02-N4; LCSC Part C2934560
U3: MT6701CT-STD-R; SOP-8_L4.9-W3.9-P1.27-LS6.0-BL; MPN MT6701CT-STD-R; LCSC Part C3003196
U4: SIT65HVD230DR; SOP-8_L4.9-W3.9-P1.27-LS6.0-BL; MPN SIT65HVD230DR; LCSC Part C496619
USBC1: TYPE-C-31-M-12; USB-C_SMD-TYPE-C-31-M-12_1; MPN TYPE-C-31-M-12; LCSC Part C165948

Connections:
+3V3: C2.2, C3.2, C5.1, C6.1, C7.2, C12.1, D3.2 (A), J2.2, L1.2, R2.2, R3.1, R5.1, R8.1, U1.1 (FB), U2.1 (3V3), U3.1 (VDD), U4.3 (VCC); also elsewhere on the board
/CAN_H: CN1.3, CN5.3, R11.2, U4.7 (CANH)
/CAN_L: CN1.2, CN5.2, R11.1, U4.6 (CANL)
/CAN_RX: U2.11 (RXD), U4.4 (R)
/CAN_TX: U2.12 (TXD), U4.1 (D)
/DRV_DIR: J3.8, U2.4 (IO5)
/DRV_EN: J3.1, U2.5 (IO6)
/DRV_RX: J3.4, R10.1
/DRV_STEP: J3.7, U2.3 (IO4)
/DRV_TX: J3.5, U2.10 (IO10)
/ENC_CLK: U2.17 (IO1), U3.7 (B)
/ENC_CSN: U2.18 (IO0), U3.8 (Z)
/ENC_DO: U2.15 (IO3), U3.6 (A)
/USB_D+: U2.14 (IO19), USBC1.A6 (DP1), USBC1.B6 (DP2)
/USB_D−: U2.13 (IO18), USBC1.A7 (DN1), USBC1.B7 (DN2)
/VBUCK: C4.1, D1.1 (K), D2.1 (K), U1.2 (EN), U1.3 (VIN)
/VBUS: D2.2 (A), USBC1.A4B9 (VBUS), USBC1.B4A9 (VBUS)
GND: C2.1, C3.1, C4.2, C5.2, C6.2, C7.1, C9.2, C10.2, C11.2, C12.2, CN1.1, CN3.2, CN4.2, CN5.1, D4.1 (K), J1.1, J2.1, J3.2, J3.3, R6.1, R7.1, R9.2, U1.4 (GND), U2.9 (GND), U2.19 (EP), U3.4 (GND), U4.2 (GND), USBC1.1 (EH), USBC1.2 (EH), USBC1.3 (EH), USBC1.4 (EH), USBC1.A1B12 (GND), USBC1.B1A12 (GND); also elsewhere on the board
unnamed: D3.1 (K), R4.1
unnamed: D4.2 (A), R5.2
unnamed: C1.1, U1.6 (BST)
unnamed: C1.2, L1.1, U1.5 (SW)
unnamed: R2.1, U2.16 (IO2)
unnamed: R10.2, U2.6 (IO7)
unnamed: R3.2, R4.2, U2.7 (IO8)
unnamed: R8.2, U3.2 (MODE)
unnamed: R9.1, U4.8 (RS)
unnamed: R6.2, USBC1.A5 (CC1)
unnamed: R7.2, USBC1.B5 (CC2)
VMOT: C9.1, C10.1, C11.1, CN3.1, CN4.1, D1.2 (A), J1.2

Notes on the sheet:
Power LED
Motor connects to the free driver pins
VIO
10 µF + 100 nF at the 3V3 pin - local charge reservoir for fast switching current.
CLK
VMOT 12-24 V (20 V nominal). TMC2209 abs max 29 V.
CAN termination. Populate ONLY on the two boards at the physical ends of the bus (first and last). Leave unpopulated on all others
STEP
MS1
D1/D2 OR 20 V and USB 5 V into the buck Logic can run on USB alone, motor power off. D1 also blocks reverse polarity.
MS2
GND
GND
DIR

Board: 2 copper layers, 40 parts (3 on the bottom side), 31 nets, no tracks yet.

Other parts of the board:
C8: 100nF; C_0603_1608Metric
R1: 10kΩ; R_0603_1608Metric

Their connections:
+3V3: R1.1; also elsewhere on the board
GND: C8.2; also elsewhere on the board
unnamed: C8.1, R1.2
