samer-cyber/Robotic-Arm/(commit log)

2026-11-07 Six-axis robot arm: firmware 1.3.0, digital twin, gearbox generator v7
    First public import, reorganised into firmware/, host/, description/,
    hardware/, ros2/, docs/ and archive/.
    Firmware 1.3.0
    - Gear ratios 16/21/16. The boxes are inverted cycloids (pin carrier on the
    motor, roller drum turns), so the ratio is the roller count; 15/20/15 made
    every stepper joint fall 5-6 % short.
    - Continuous-rotation gripper: timed close-then-hold, timed open-then-stop,
    every drive capped, settings in their own NVS key.
    Host
    - 6-DOF FK/IK from description/arm.json (damped least squares, limits).
    - 3D twin in the control panel: live mirror from the CAD meshes, drag a
    target, IK ghost preview, Go. G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
    [Arm sizing calculator.xlsx, Arm.stl, Body 1.stl, Body 2.stl, Body 3.stl, Body 4.stl, Body 5.stl, Body 6.stl]
2026-11-07 Twin panel: three-step type scale (11 / 14 / 18 px)
    Six font sizes between 10.5 and 14 px gave the side panel no hierarchy.
    Labels, body and title now sit ~1.27x apart; the panel widens to 344 px so
    the button rows still fit on one line.
